Triweekly/SmartGarden/UCF website files/images/kevin.jpg

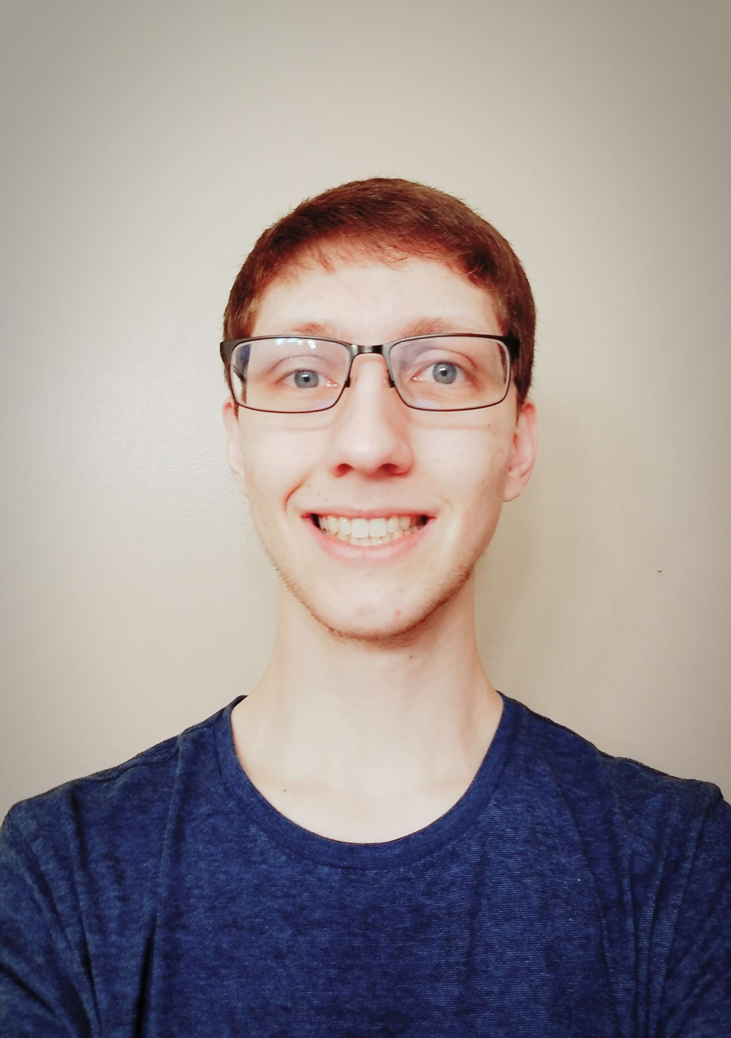
UCF website files/images/kevin.jpg
