Triweekly/SmartGarden/UCF website files/images/lauren.jpg

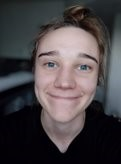
UCF website files/images/lauren.jpg
