Triweekly/SmartGarden/UCF website files/images/HardwareDiagram.png

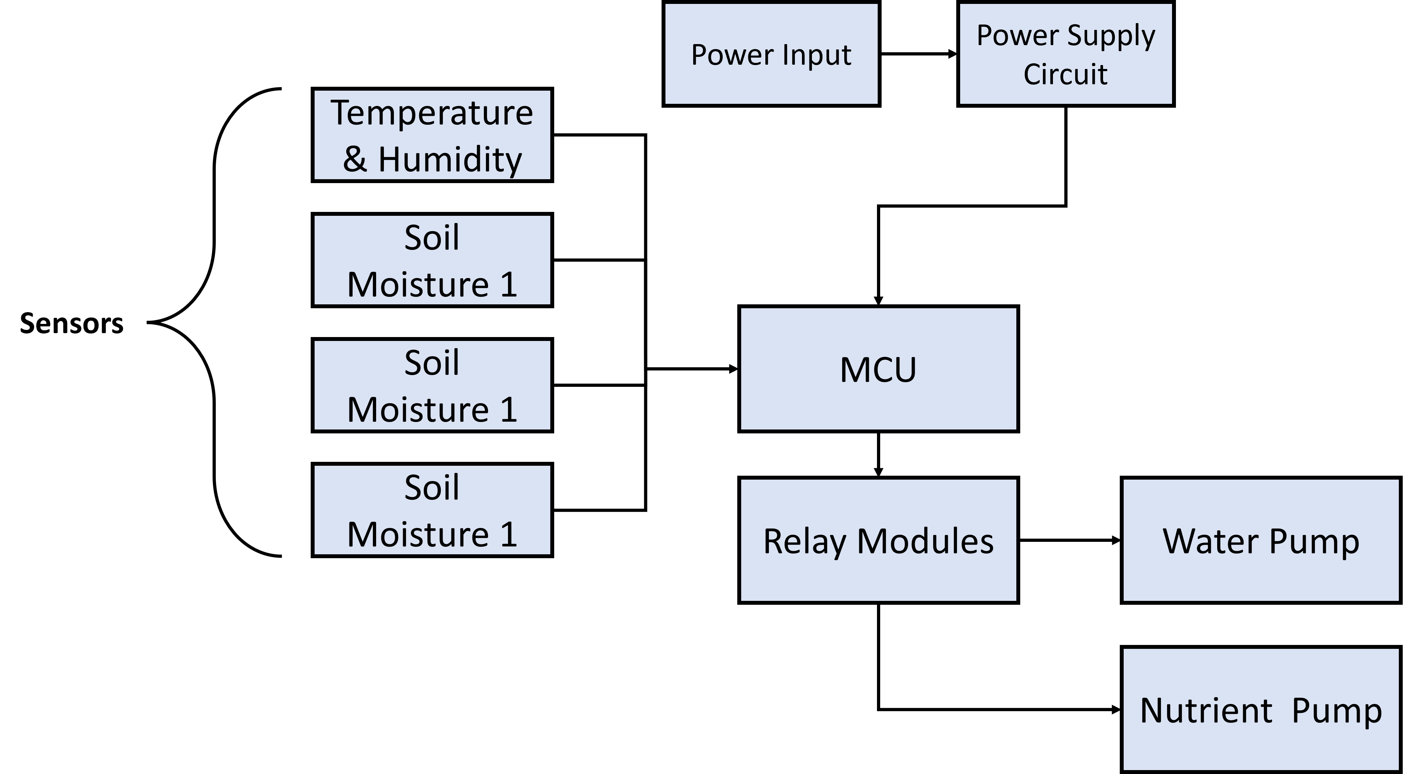
UCF website files/images/HardwareDiagram.png
