Triweekly/SmartGarden/UCF website files/images/SoftwareDiagram.png

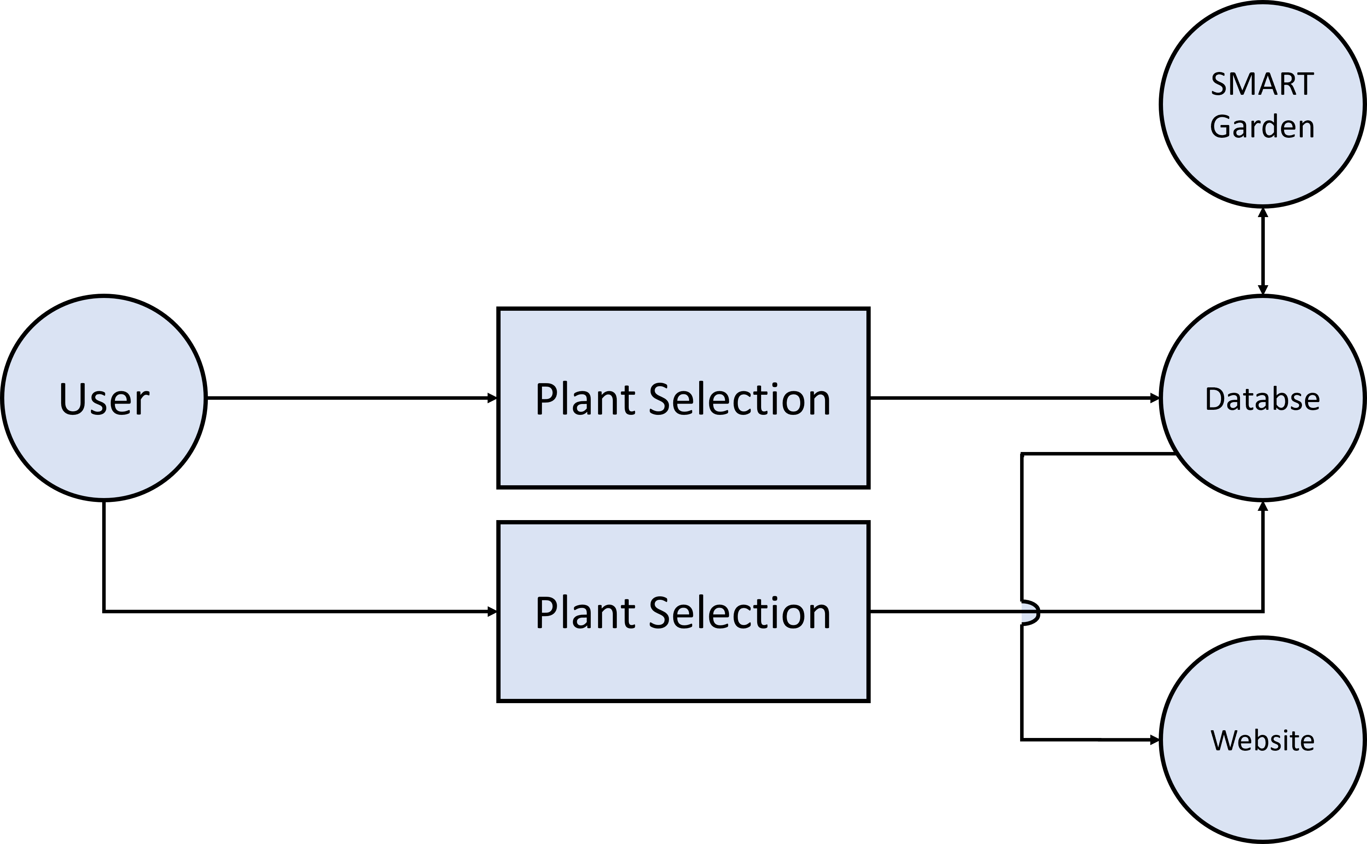
UCF website files/images/SoftwareDiagram.png
