Triweekly/SmartGarden/(commit log)

2023-03-14 New stuff for html
    trying to get the basics of the landing page down, even if it doesn't do anything
2023-03-16 url change for newPlant.php access
    added printout for debug to js
2023-03-16 debug print
2023-03-18 adding commented out next row
    has ids so a javascript can change their values for the current plant's ideal values. See parseReadings() in script.js for syntax
2023-03-18 changed a generic input to a button with onclick
2023-03-18 event.preventdefault()
    currently shown as deprecated but if it works, then *shrug*
2023-03-18 new file for arduino to check in the future.
2023-03-19 workaround? also back to button vs input type="button"
2023-03-19 script INSIDE button?
2023-03-19 forgot to save the html 💀
    added class to hideable items that should make them easy to hide all at once. Line breaks are in the labels making it easier to organize them, but we should use CSS at some point
2023-03-20 adds functionality to submit button
    Custom won't work yet, but others should be fine
2023-03-20 need to change name in currentreadings
2023-03-20 setPlant also updates currentreadings name
2023-03-30 updated refresh button. now is the symbol next to the caption instead of the whole thing
    this guy-> ⟲
2023-03-31 added function onceMore() to body onload
    a repeating function that calls loadReadings(); every 15 seconds and sets a new timer to call itself 15 seconds later
2023-03-31 added checkprefs to the timer too, just in case
2023-04-02 crossing fingers that this all makes the dropdown fill dynamically
2023-04-02 index: changed order. js: added print log
2023-04-03 a few things
    index: changed UV to temp(low) and moved it.
    js: added a function to set custom fields to current custom values when loading.
    php: added a file to retrieve said values
2023-04-10 re-commit i think. I have reverted a couple things and am confused
2023-04-24 table is centered
    Probably don't push the current version to the server anymore.
2023-04-24 Add files via upload
    The video is 652 megabytes for the final video demo. So I attached the form which contains the YouTube link to the YouTube videos for the final demo, prezi and conference paper
2023-04-24 current version
